ldjennings/driver-radio/pcb/driver-radio.kicad_pcb

## KiCad design pcb/driver-radio.kicad_pcb (2026-05-05)

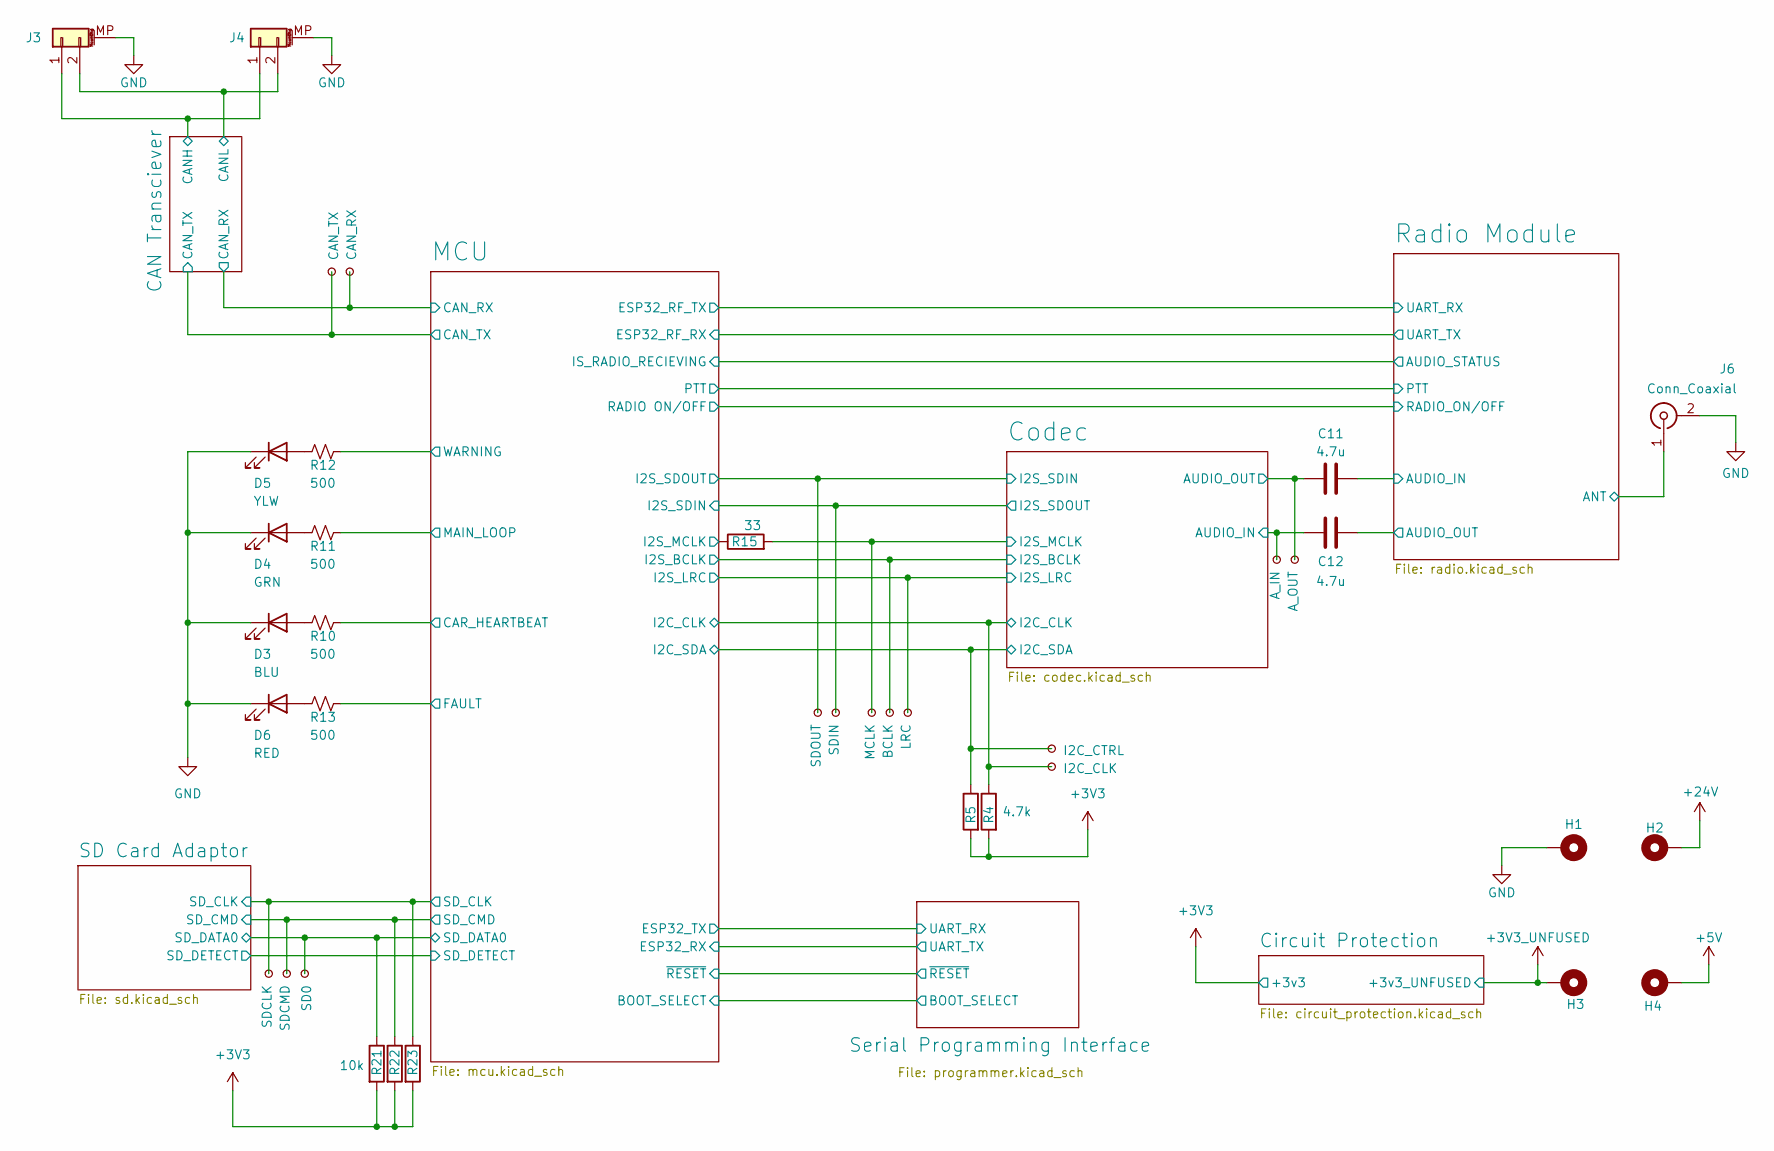
[picture p1: schematic driver-radio.kicad_sch, Driver Radio Control Board]

Parts:
C11, C12: 4.7u; C_0805_2012Metric
D3: BLU; LED_0402_1005Metric
D4: GRN; LED_0402_1005Metric
D5: YLW; LED_0402_1005Metric
D6: RED; LED_0402_1005Metric
H1, H2, H3, H4: MountingHole_Pad; glv_mainboard_hole
J3, J4: Conn_01x02_MountingPin; JST_GH_SM02B-GHS-TB_1x02-1MP_P1.25mm_Horizontal
J6: Conn_Coaxial; SMA_Molex_73251-1153_EdgeMount_Horizontal
R4, R5: 4.7k; R_0402_1005Metric
R10, R11, R12, R13: 500; R_0402_1005Metric
R15: 33; R_0402_1005Metric
R21, R22, R23: 10k; R_0402_1005Metric_Pad0.72x0.64mm_HandSolder
TP1: CAN_TX; tp-ev24-nobacksilk
TP2: CAN_RX; tp-ev24-nobacksilk
TP3: I2C_CTRL; tp-ev24-nobacksilk
TP4: I2C_CLK; tp-ev24-nobacksilk
TP5: MCLK; tp-ev24-nobacksilk
TP6: LRC; tp-ev24-nobacksilk
TP7: BCLK; tp-ev24-nobacksilk
TP8: SDIN; tp-ev24-nobacksilk
TP9: SDOUT; tp-ev24-nobacksilk
TP10: A_OUT; tp-ev24-nobacksilk
TP11: A_IN; tp-ev24-nobacksilk
TP12: SD0; tp-ev24-nobacksilk
TP16: SDCLK; tp-ev24-nobacksilk
TP17: SDCMD; tp-ev24-nobacksilk

Connections:
+3V3: R4.2, R5.2, R21.2, R22.2, R23.2; also elsewhere on the board
+3V3_UNFUSED: H3.1; also elsewhere on the board
+5V: H4.1; also elsewhere on the board
+24V: H2.1
/CAN Transciever/CANH: J3.1, J4.1; also elsewhere on the board
/CAN Transciever/CANL: J3.2, J4.2; also elsewhere on the board
/CAN Transciever/CAN_RX: TP2.1; also elsewhere on the board
/CAN Transciever/CAN_TX: TP1.1; also elsewhere on the board
/Codec/AUDIO_IN: C12.2, TP11.1; also elsewhere on the board
/Codec/AUDIO_OUT: C11.2, TP10.1; also elsewhere on the board
/Codec/I2C_CLK: R4.1, TP4.1; also elsewhere on the board
/Codec/I2C_SDA: R5.1, TP3.1; also elsewhere on the board
/Codec/I2S_BCLK: TP7.1; also elsewhere on the board
/Codec/I2S_LRC: TP6.1; also elsewhere on the board
/Codec/I2S_MCLK: R15.2, TP5.1; also elsewhere on the board
/Codec/I2S_SDIN: TP9.1; also elsewhere on the board
/Codec/I2S_SDOUT: TP8.1; also elsewhere on the board
/MCU/BOOT_SELECT: R15.1; also elsewhere on the board
/MCU/CAR_HEARTBEAT: R10.1; also elsewhere on the board
/MCU/FAULT: R13.1; also elsewhere on the board
/MCU/MAIN_LOOP: R11.1; also elsewhere on the board
/MCU/SD_CLK: R23.1, TP16.1; also elsewhere on the board
/MCU/SD_CMD: R22.1, TP17.1; also elsewhere on the board
/MCU/SD_DATA0: R21.1, TP12.1; also elsewhere on the board
/MCU/WARNING: R12.1; also elsewhere on the board
/Radio Module/ANT: J6.1 (In); also elsewhere on the board
/Radio Module/AUDIO_IN: C11.1; also elsewhere on the board
/Radio Module/AUDIO_OUT: C12.1; also elsewhere on the board
GND: D3.1 (K), D4.1 (K), D5.1 (K), D6.1 (K), H1.1, J3.MP (MountPin), J4.MP (MountPin), J6.2 (Ext); also elsewhere on the board
unnamed: D3.2 (A), R10.2
unnamed: D4.2 (A), R11.2
unnamed: D5.2 (A), R12.2
unnamed: D6.2 (A), R13.2

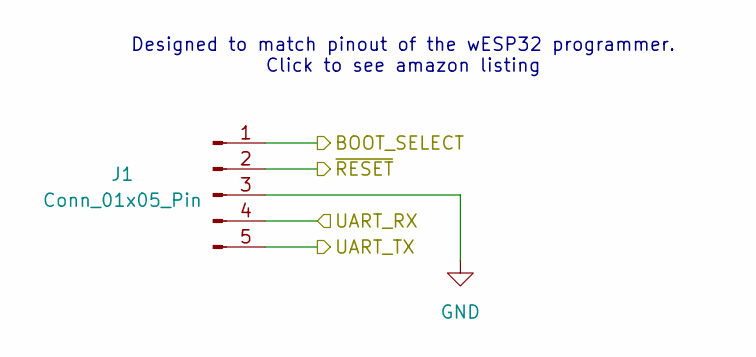
[picture p2: schematic programmer.kicad_sch, Serial Programming Interface]

Parts:
J1: Conn_01x05_Pin; PinHeader_1x05_P2.54mm_Vertical

Connections:
/MCU/BOOT_SELECT: J1.1; also elsewhere on the board
/MCU/ESP32_RX: J1.5; also elsewhere on the board
/MCU/ESP32_TX: J1.4; also elsewhere on the board
/MCU/~RESET: J1.2; also elsewhere on the board
GND: J1.3; also elsewhere on the board

Notes on the sheet:
Designed to match pinout of the wESP32 programmer. Click to see amazon listing

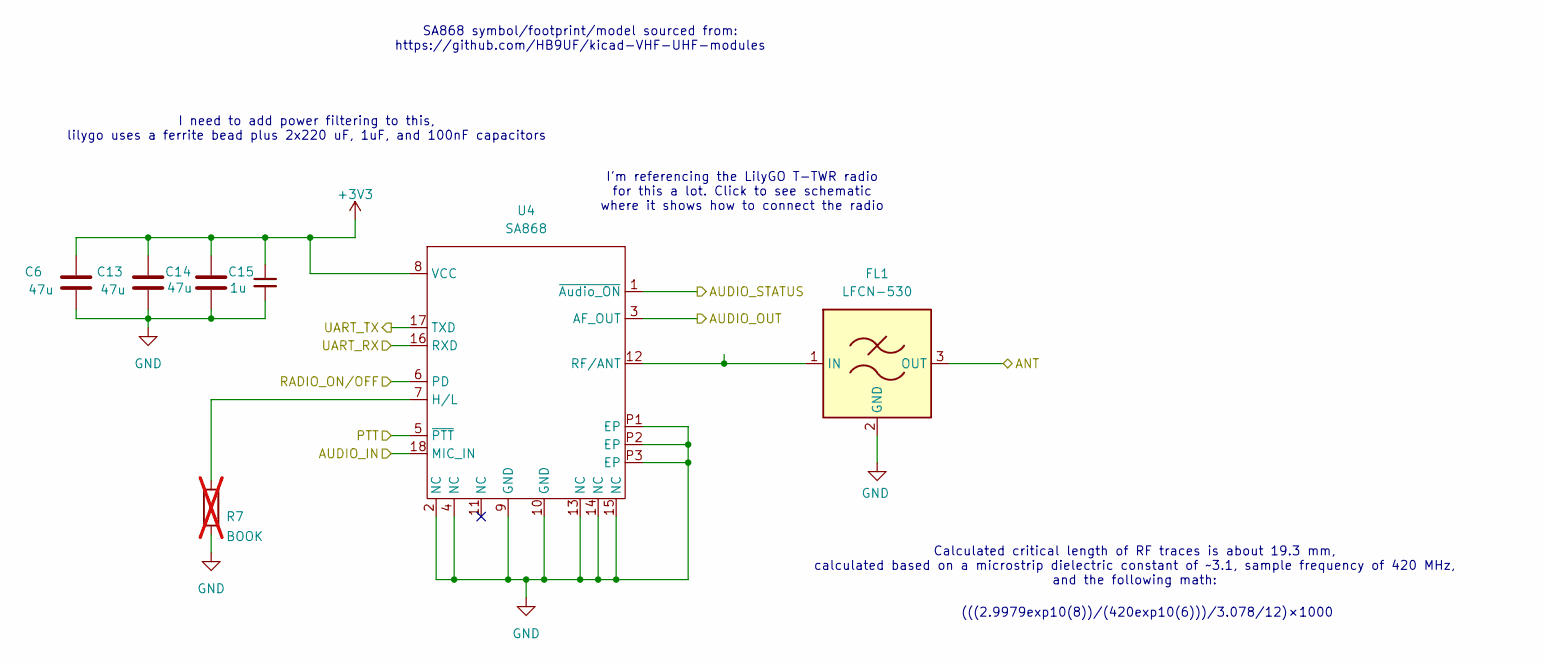
[picture p3: schematic radio.kicad_sch, Radio Module: SA868]

Parts:
C6, C13, C14: 47u; C_1206_3216Metric
C15: 1u; C_0402_1005Metric
FL1: LFCN-530; Filter_Mini-Circuits_FV1206
R7: BOOK; R_0402_1005Metric; not fitted
U4: SA868; VHF_UHF_Module_generic

Connections:
+3V3: C6.1, C13.1, C14.1, C15.1, U4.8 (VCC); also elsewhere on the board
/MCU/ESP32_RF_RX: U4.17 (TXD); also elsewhere on the board
/MCU/ESP32_RF_TX: U4.16 (RXD); also elsewhere on the board
/MCU/IS_RADIO_RECIEVING: U4.1 (~Audio_ON); also elsewhere on the board
/MCU/PTT: U4.5 (~PTT); also elsewhere on the board
/MCU/RADIO ON/OFF: U4.6 (PD); also elsewhere on the board
/Radio Module/ANT: FL1.3 (OUT); also elsewhere on the board
/Radio Module/AUDIO_IN: U4.18 (MIC_IN); also elsewhere on the board
/Radio Module/AUDIO_OUT: U4.3 (AF_OUT); also elsewhere on the board
GND: C6.2, C13.2, C14.2, C15.2, FL1.2 (GND), FL1.4 (GND), R7.1, U4.2 (NC), U4.4 (NC), U4.9 (GND), U4.10 (GND), U4.13 (NC), U4.14 (NC), U4.15 (NC), U4.P1 (EP), U4.P2 (EP), U4.P3 (EP); also elsewhere on the board
unnamed: FL1.1 (IN), U4.12 (RF/ANT)
unnamed: R7.2, U4.7 (H/L)

Notes on the sheet:
I'm referencing the LilyGO T-TWR radio for this a lot. Click to see schematic where it shows how to connect the radio
SA868 symbol/footprint/model sourced from: https://github.com/HB9UF/kicad-VHF-UHF-modules
I need to add power filtering to this, lilygo uses a ferrite bead plus 2x220 uF, 1uF, and 100nF capacitors
Calculated critical length of RF traces is about 19.3 mm, calculated based on a microstrip dielectric constant of ~3.1, sample frequency of 420 MHz, and the following math:
(((2.9979exp10(8))/(420exp10(6)))/3.078/12)×1000

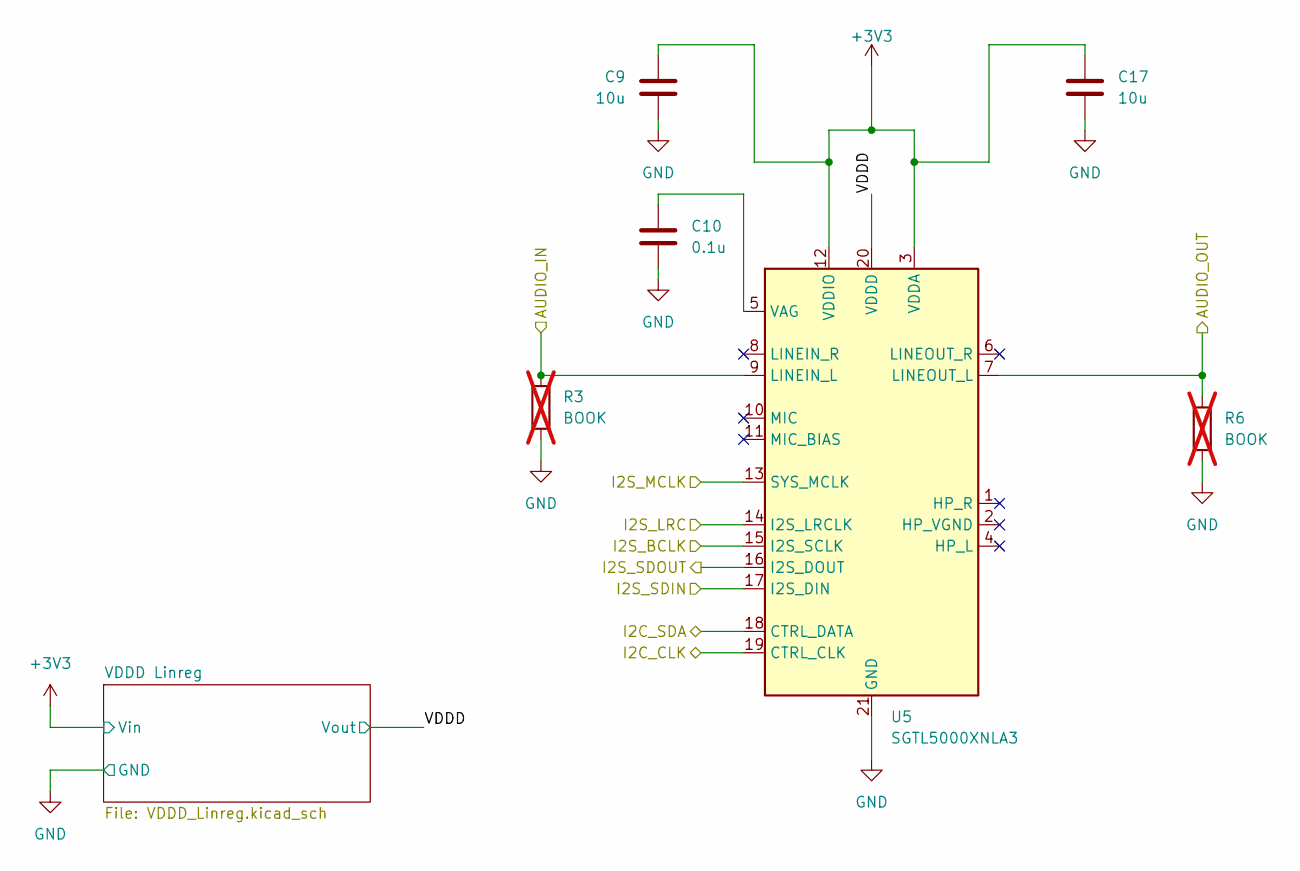
[picture p4: schematic codec.kicad_sch, Codec (SGTL5000)]

Parts:
C9, C17: 10u; C_0402_1005Metric
C10: 0.1u; C_0402_1005Metric
R3, R6: BOOK; R_0402_1005Metric; not fitted
U5: SGTL5000XNLA3; QFN-20-1EP_3x3mm_P0.4mm_EP1.65x1.65mm

Connections:
+3V3: C9.1, C17.1, U5.3 (VDDA), U5.12 (VDDIO); also elsewhere on the board
/Codec/AUDIO_IN: R3.2, U5.9 (LINEIN_L); also elsewhere on the board
/Codec/AUDIO_OUT: R6.2, U5.7 (LINEOUT_L); also elsewhere on the board
/Codec/I2C_CLK: U5.19 (CTRL_CLK); also elsewhere on the board
/Codec/I2C_SDA: U5.18 (CTRL_DATA); also elsewhere on the board
/Codec/I2S_BCLK: U5.15 (I2S_SCLK); also elsewhere on the board
/Codec/I2S_LRC: U5.14 (I2S_LRCLK); also elsewhere on the board
/Codec/I2S_MCLK: U5.13 (SYS_MCLK); also elsewhere on the board
/Codec/I2S_SDIN: U5.17 (I2S_DIN); also elsewhere on the board
/Codec/I2S_SDOUT: U5.16 (I2S_DOUT); also elsewhere on the board
/Codec/VDDD: U5.20 (VDDD); also elsewhere on the board
GND: C9.2, C10.2, C17.2, R3.1, R6.1, U5.21 (GND); also elsewhere on the board
unnamed: C10.1, U5.5 (VAG)

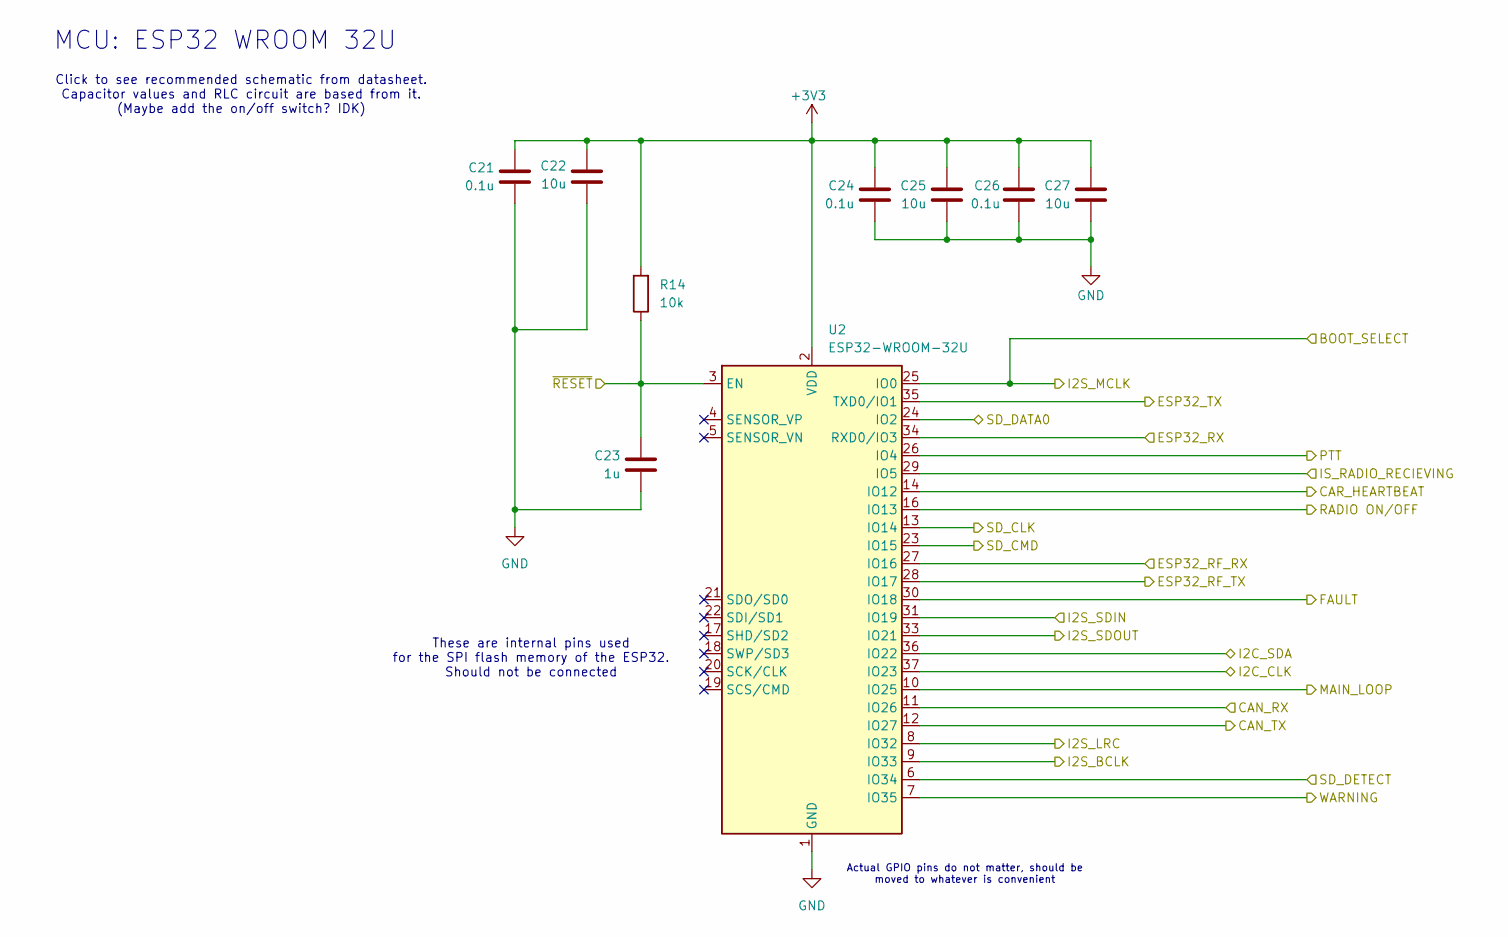
[picture p5: schematic mcu.kicad_sch, MCU: ESP32-WROOM32D]

Parts:
C21, C24, C26: 0.1u; C_0402_1005Metric
C22, C25, C27: 10u; C_0402_1005Metric
C23: 1u; C_0402_1005Metric
R14: 10k; R_0402_1005Metric
U2: ESP32-WROOM-32U

Connections:
+3V3: C21.1, C22.1, C24.1, C25.1, C26.1, C27.1, R14.2, U2.2 (VDD); also elsewhere on the board
/CAN Transciever/CAN_RX: U2.11 (IO26); also elsewhere on the board
/CAN Transciever/CAN_TX: U2.12 (IO27); also elsewhere on the board
/Codec/I2C_CLK: U2.37 (IO23); also elsewhere on the board
/Codec/I2C_SDA: U2.36 (IO22); also elsewhere on the board
/Codec/I2S_BCLK: U2.9 (IO33); also elsewhere on the board
/Codec/I2S_LRC: U2.8 (IO32); also elsewhere on the board
/Codec/I2S_SDIN: U2.33 (IO21); also elsewhere on the board
/Codec/I2S_SDOUT: U2.31 (IO19); also elsewhere on the board
/MCU/BOOT_SELECT: U2.25 (IO0); also elsewhere on the board
/MCU/CAR_HEARTBEAT: U2.14 (IO12); also elsewhere on the board
/MCU/ESP32_RF_RX: U2.27 (IO16); also elsewhere on the board
/MCU/ESP32_RF_TX: U2.28 (IO17); also elsewhere on the board
/MCU/ESP32_RX: U2.34 (RXD0/IO3); also elsewhere on the board
/MCU/ESP32_TX: U2.35 (TXD0/IO1); also elsewhere on the board
/MCU/FAULT: U2.30 (IO18); also elsewhere on the board
/MCU/IS_RADIO_RECIEVING: U2.29 (IO5); also elsewhere on the board
/MCU/MAIN_LOOP: U2.10 (IO25); also elsewhere on the board
/MCU/PTT: U2.26 (IO4); also elsewhere on the board
/MCU/RADIO ON/OFF: U2.16 (IO13); also elsewhere on the board
/MCU/SD_CLK: U2.13 (IO14); also elsewhere on the board
/MCU/SD_CMD: U2.23 (IO15); also elsewhere on the board
/MCU/SD_DATA0: U2.24 (IO2); also elsewhere on the board
/MCU/SD_DETECT: U2.6 (IO34); also elsewhere on the board
/MCU/WARNING: U2.7 (IO35); also elsewhere on the board
/MCU/~RESET: C23.2, R14.1, U2.3 (EN); also elsewhere on the board
GND: C21.2, C22.2, C23.1, C24.2, C25.2, C26.2, C27.2, U2.1 (GND), U2.15 (GND), U2.38 (GND), U2.39 (GND); also elsewhere on the board

Notes on the sheet:
Actual GPIO pins do not matter, should be moved to whatever is convenient
Click to see recommended schematic from datasheet. Capacitor values and RLC circuit are based from it. (Maybe add the on/off switch? IDK)
These are internal pins used for the SPI flash memory of the ESP32. Should not be connected
MCU: ESP32 WROOM 32U

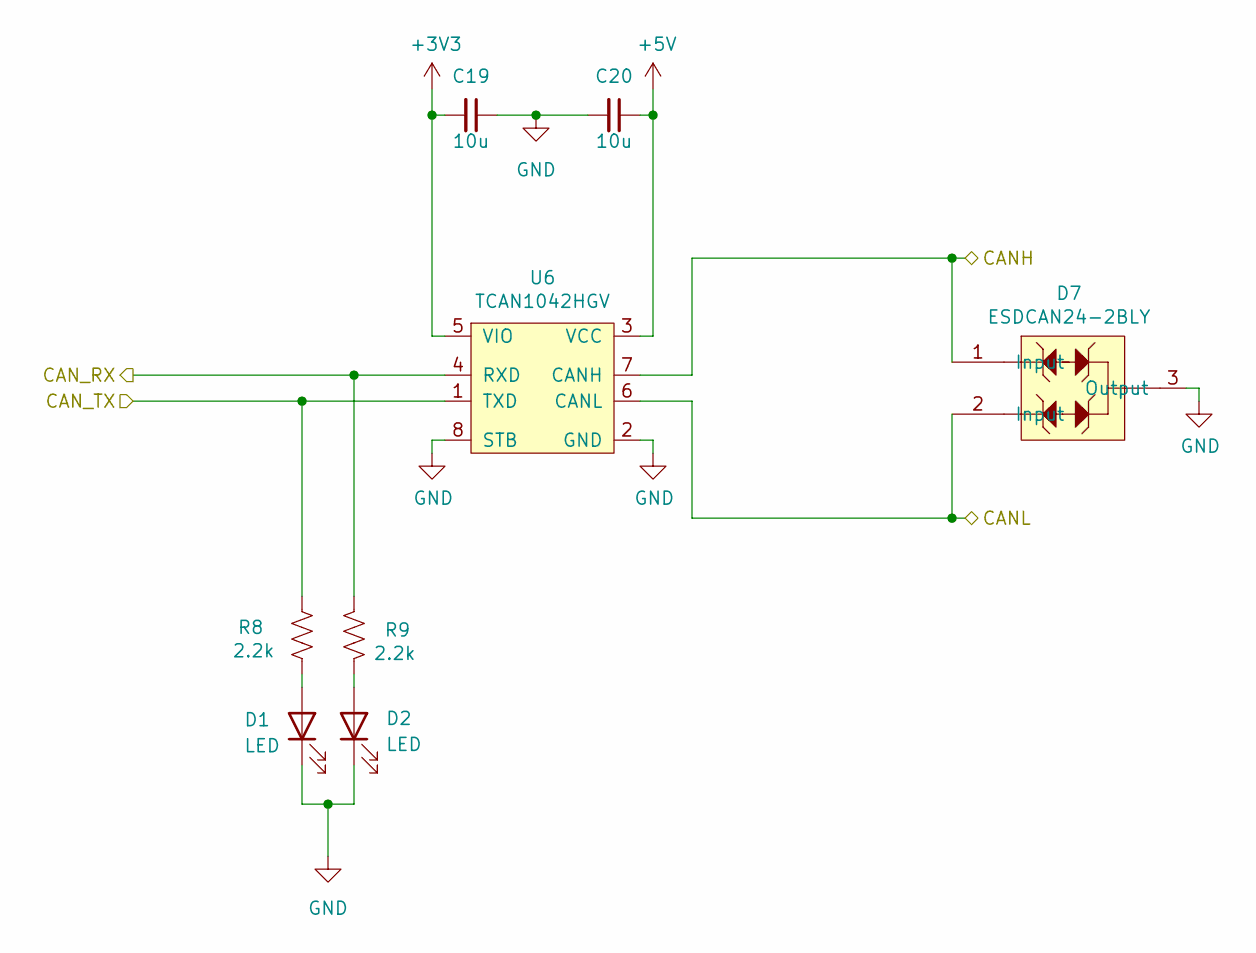
[picture p6: schematic transciever-can.kicad_sch, CAN Transciever]

Parts:
C19, C20: 10u; C_0402_1005Metric
D1, D2: LED; LED_0402_1005Metric
D7: ESDCAN24-2BLY; SOT-23-3
R8, R9: 2.2k; R_0402_1005Metric
U6: TCAN1042HGV; SOIC-8_3.9x4.9mm_P1.27mm

Connections:
+3V3: C19.2, U6.5 (VIO); also elsewhere on the board
+5V: C20.1, U6.3 (VCC); also elsewhere on the board
/CAN Transciever/CANH: D7.1 (Input), U6.7 (CANH); also elsewhere on the board
/CAN Transciever/CANL: D7.2 (Input), U6.6 (CANL); also elsewhere on the board
/CAN Transciever/CAN_RX: R9.1, U6.4 (RXD); also elsewhere on the board
/CAN Transciever/CAN_TX: R8.1, U6.1 (TXD); also elsewhere on the board
GND: C19.1, C20.2, D1.1 (K), D2.1 (K), D7.3 (Output), U6.2 (GND), U6.8 (STB); also elsewhere on the board
unnamed: D1.2 (A), R8.2
unnamed: D2.2 (A), R9.2

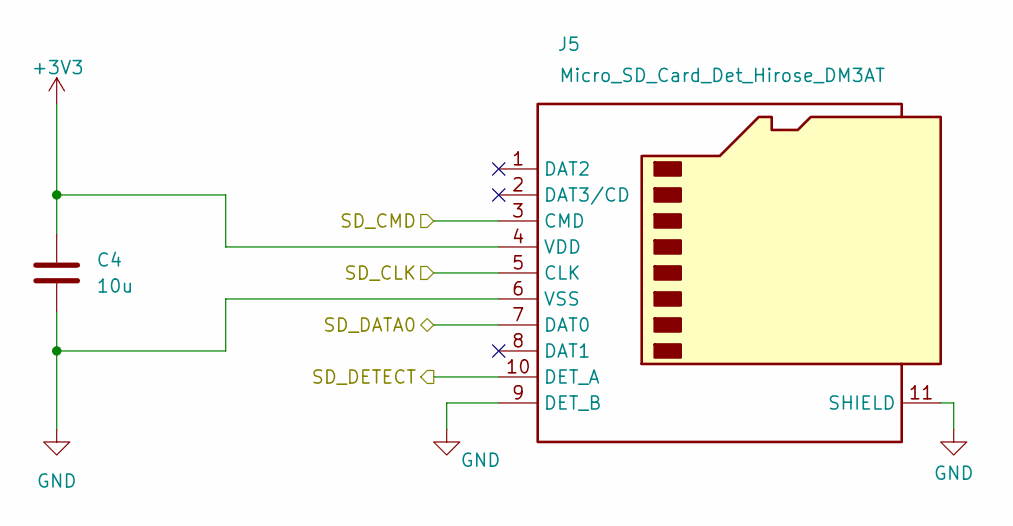
[picture p7: schematic sd.kicad_sch, SD Card Adaptor]

Parts:
C4: 10u; C_0402_1005Metric
J5: Micro_SD_Card_Det_Hirose_DM3AT; microSD_HC_Hirose_DM3BT-DSF-PEJS

Connections:
+3V3: C4.1, J5.4 (VDD); also elsewhere on the board
/MCU/SD_CLK: J5.5 (CLK); also elsewhere on the board
/MCU/SD_CMD: J5.3 (CMD); also elsewhere on the board
/MCU/SD_DATA0: J5.7 (DAT0); also elsewhere on the board
/MCU/SD_DETECT: J5.10 (DET_A); also elsewhere on the board
GND: C4.2, J5.6 (VSS), J5.9 (DET_B), J5.11 (SHIELD); also elsewhere on the board

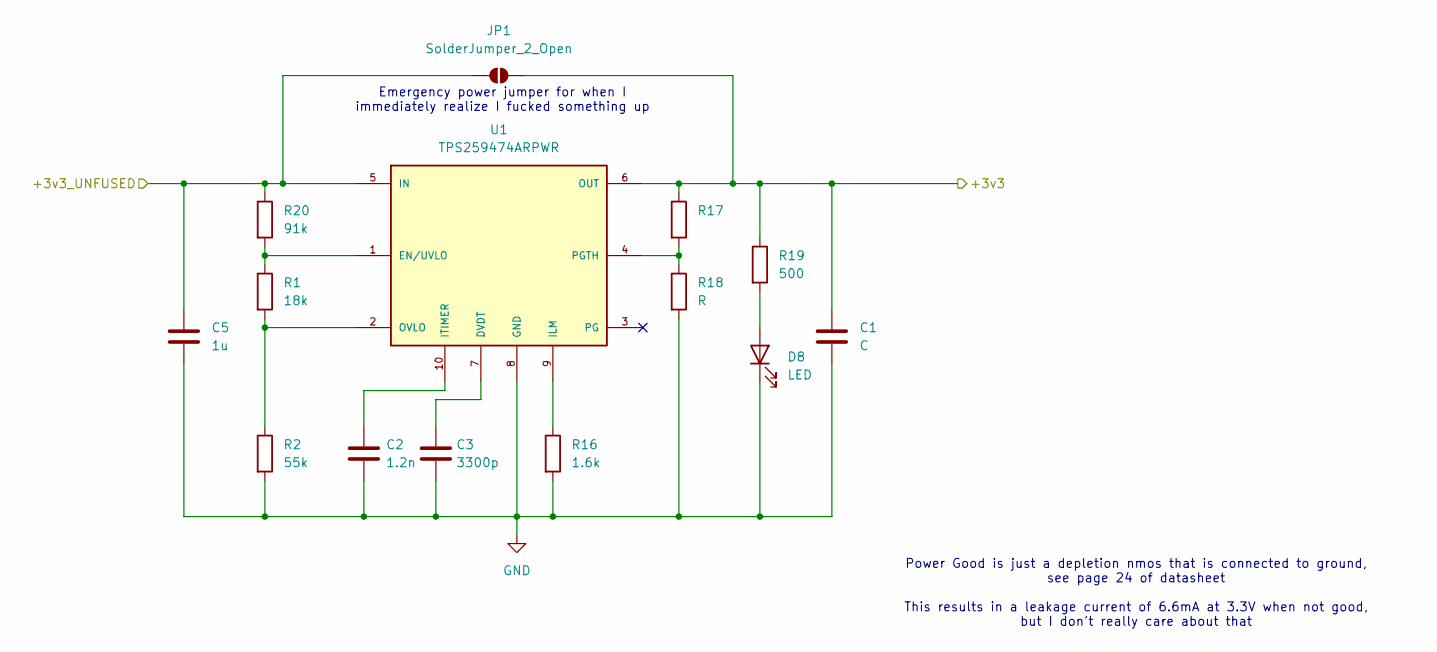
[picture p8: schematic circuit_protection.kicad_sch, Efuse Circuit Protection]

Parts:
C1: C; C_0402_1005Metric
C2: 1.2n; C_0402_1005Metric
C3: 3300p; C_0402_1005Metric
C5: 1u; C_0402_1005Metric
D8: LED; D_0402_1005Metric
JP1: SolderJumper_2_Open; SolderJumper-2_P1.3mm_Open_RoundedPad1.0x1.5mm
R1: 18k; R_0402_1005Metric
R2: 55k; R_0402_1005Metric
R16: 1.6k; R_0402_1005Metric
R17: R_0402_1005Metric
R18: R; R_0402_1005Metric
R19: 500; R_0402_1005Metric
R20: 91k; R_0402_1005Metric
U1: TPS259474ARPWR; IC_TPS259474ARPWR; PARTREV A

Connections:
+3V3: C1.1, JP1.2 (B), R17.1, R19.1, U1.6 (OUT); also elsewhere on the board
+3V3_UNFUSED: C5.1, JP1.1 (A), R20.1, U1.5 (IN); also elsewhere on the board
GND: C1.2, C2.2, C3.2, C5.2, D8.1 (K), R2.2, R16.2, R18.2, U1.8 (GND); also elsewhere on the board
unnamed: D8.2 (A), R19.2
unnamed: C3.1, U1.7 (DVDT)
unnamed: R1.1, R20.2, U1.1 (EN/UVLO)
unnamed: R16.1, U1.9 (ILM)
unnamed: C2.1, U1.10 (ITIMER)
unnamed: R1.2, R2.1, U1.2 (OVLO)
unnamed: R17.2, R18.1, U1.4 (PGTH)

Notes on the sheet:
Power Good is just a depletion nmos that is connected to ground, see page 24 of datasheet This results in a leakage current of 6.6mA at 3.3V when not good, but I don't really care about that
Emergency power jumper for when I immediately realize I fucked something up

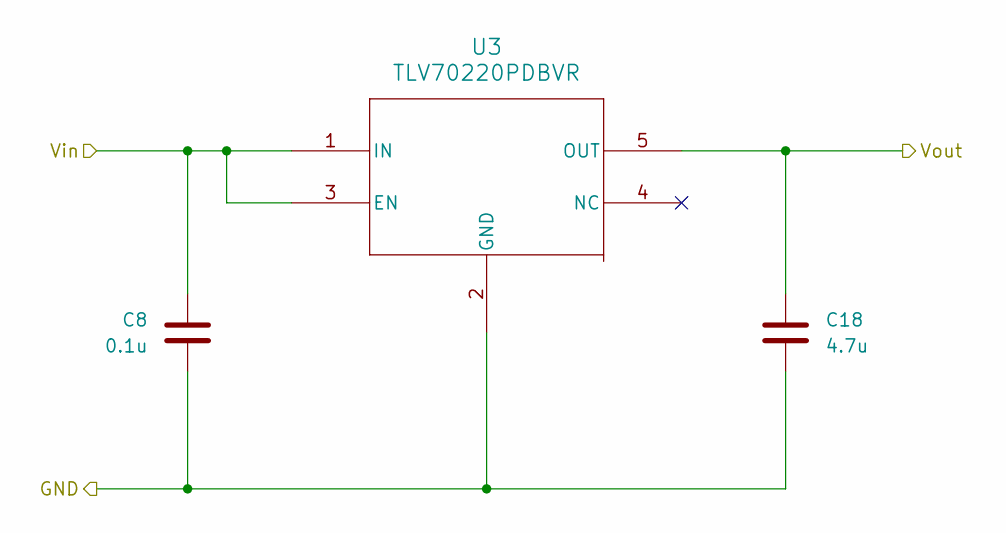
[picture p9: schematic VDDD_Linreg.kicad_sch, VDDD Linreg (3.3V - 2.0V)]

Parts:
C8: 0.1u; C_0402_1005Metric
C18: 4.7u; C_0402_1005Metric
U3: TLV70220PDBVR; SOT-23-5

Connections:
+3V3: C8.1, U3.1 (IN), U3.3 (EN); also elsewhere on the board
/Codec/VDDD: C18.1, U3.5 (OUT); also elsewhere on the board
GND: C8.2, C18.2, U3.2 (GND); also elsewhere on the board

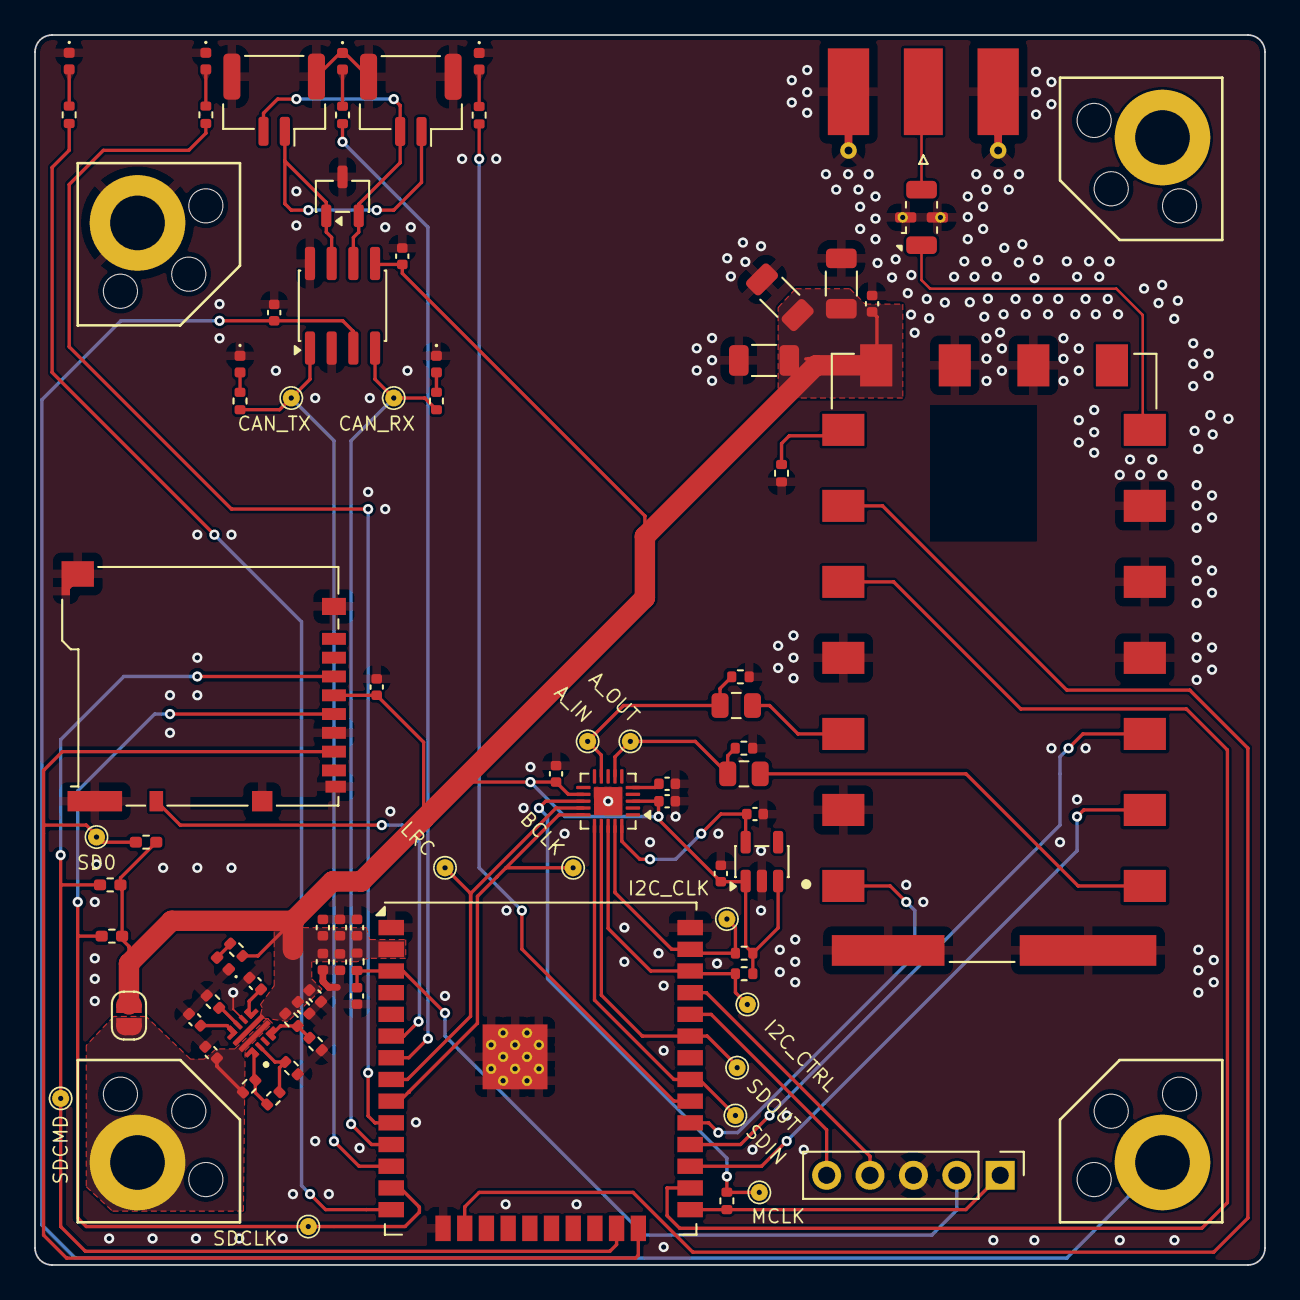
[picture p10: board driver-radio.kicad_pcb from above]

Board: 4 copper layers, 72.0 x 72.0 mm, 87 parts (0 on the bottom side), 54 nets.
