ldjennings/driver-radio/(commit log)

2025-06-10 spice stuff
    [codec_in.sch]
2025-06-10 added bom to gitignore
2025-06-10 Changed flake to actually be a flake, added direnv
    [partitions.csv]
2025-08-28 Merging in work from FSAE repo from when I forgot this one existed
    [VDDD_Linreg.kicad_sch, circuit_protection.kicad_sch, driver-radio.kicad_pcb, driver-radio.kicad_sch, mcu.kicad_sch, programmer.kicad_sch, radio.kicad_sch, sd.kicad_sch]
2025-10-05 Quite a few changes
    [circuit_protection.kicad_sch, driver-radio.kicad_pcb, driver-radio.kicad_sch, mcu.kicad_sch, radio.kicad_sch]
2026-01-05 Removed baofeng outline
    [driver-radio.kicad_pcb]
2026-05-05 updated footprints
    [driver-radio.kicad_pcb, radio.kicad_sch]
2026-05-05 added 3d model
    [driver-radio.kicad_pcb, radio.kicad_sch]
